akhumphrey/guitar-amplifiers/README.md

# Guitar Amplifiers

This repository contains the source files for the guitar amplifier projects I take on.

## The Amps

1. [1224](1224) - a 5F2-A style amplifier constructed from parts salvaged from a vintage [Philco model 1224](https://www.vintageradio.co.nz/model/philco/1224) tablegram.
1. [7vdw](7vdw) - a 6G2 style amplifier constructed from parts salvaged from the radio chassis portion of a vintage [Columbus model 7VDW](https://www.vintageradio.co.nz/model/columbus/7vdw) stereogram.

## References

I took a lot of learning and guidance from other circuits and the teaching of much more learned individuals while coming up with these designs. I stand upon the shoulders of giants, some of which are mentioned here in no particular order:

### General

- [https://el34world.com/charts/grounds.htm](https://el34world.com/charts/grounds.htm)
- [https://www.ampbooks.com/mobile/amplifier-calculators/cathode-capacitor/calculator/](https://www.ampbooks.com/mobile/amplifier-calculators/cathode-capacitor/calculator/)
- [https://www.youtube.com/playlist?list=PLhk_5-kIFMR6hYTqkiCGOVxa3RP3x8FsA](https://www.youtube.com/playlist?list=PLhk_5-kIFMR6hYTqkiCGOVxa3RP3x8FsA)
- [https://www.analogethos.com/blog/search/tube%20amplifier](https://www.analogethos.com/blog/search/tube%20amplifier)
- [https://northcoastsynthesis.com/news/how-to-choose-component-values/](https://northcoastsynthesis.com/news/how-to-choose-component-values/)
- [https://www.valvewizard.co.uk/localfeedback.html](https://www.valvewizard.co.uk/localfeedback.html)
- [https://el34world.com/charts/currentflow.htm](https://el34world.com/charts/currentflow.htm)

### Load Lines

- [https://robrobinette.com/Drawing_Tube_Load_Lines.htm](https://robrobinette.com/Drawing_Tube_Load_Lines.htm)
- [https://www.analogethos.com/post/load-lines](https://www.analogethos.com/post/load-lines)

### Biasing

- [https://robrobinette.com/How_to_Bias_a_Tube_Amp.htm](https://robrobinette.com/How_to_Bias_a_Tube_Amp.htm)
- [https://www.youtube.com/watch?v=L3rRk3eSTnA](https://www.youtube.com/watch?v=L3rRk3eSTnA)
- [https://www.youtube.com/watch?v=ucG3s863x1c](https://www.youtube.com/watch?v=ucG3s863x1c)
- [https://guitarscience.net/tsc/info.htm](https://guitarscience.net/tsc/info.htm)
- [https://www.youtube.com/watch?v=BatwDYFJ9ug](https://www.youtube.com/watch?v=BatwDYFJ9ug)
- [https://www.ampbooks.com/mobile/classic-circuits/bassman-tonestack/](https://www.ampbooks.com/mobile/classic-circuits/bassman-tonestack/)
- [https://robrobinette.com/How_The_TMB_Tone_Stack_Works.htm](https://robrobinette.com/How_The_TMB_Tone_Stack_Works.htm)
