akhumphrey/guitar-amplifiers/1224/layouts/eyelet/main.png

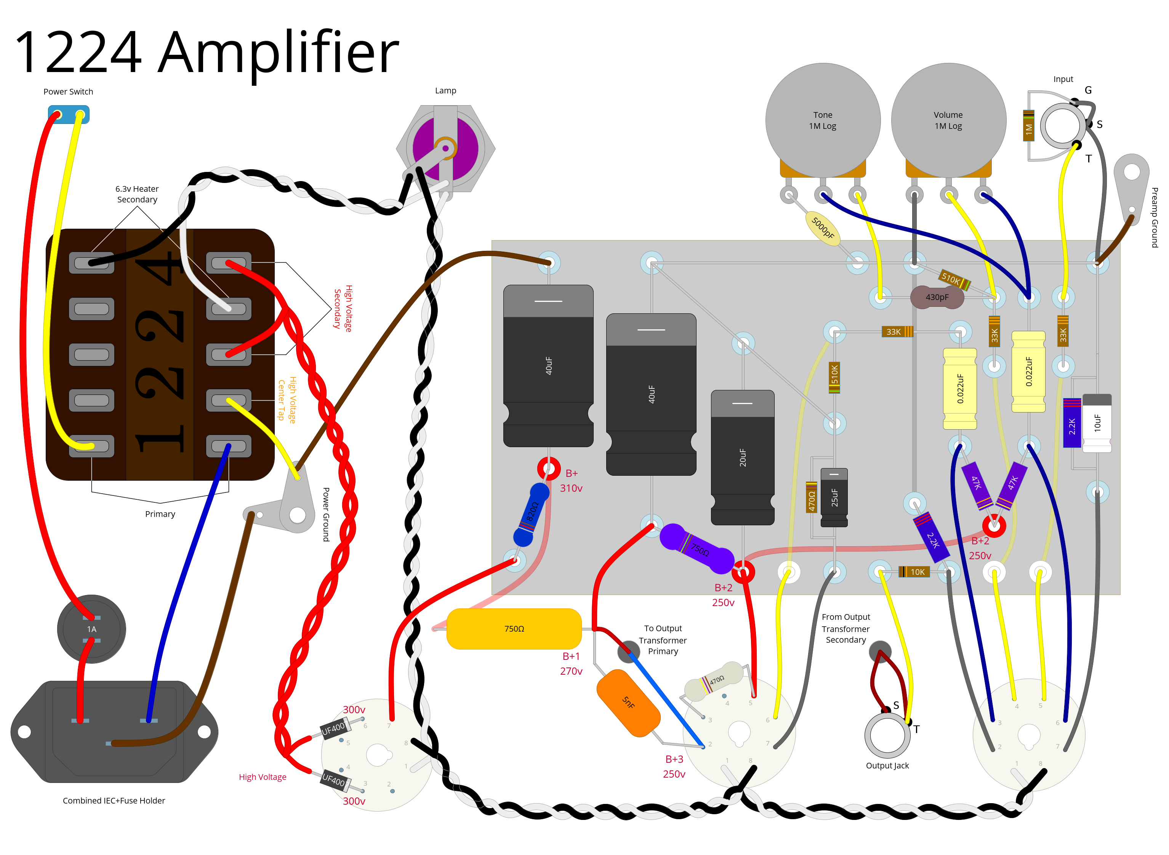
1224/layouts/eyelet/main.png
