akhumphrey/guitar-amplifiers/7vdw/layout/main.pdf

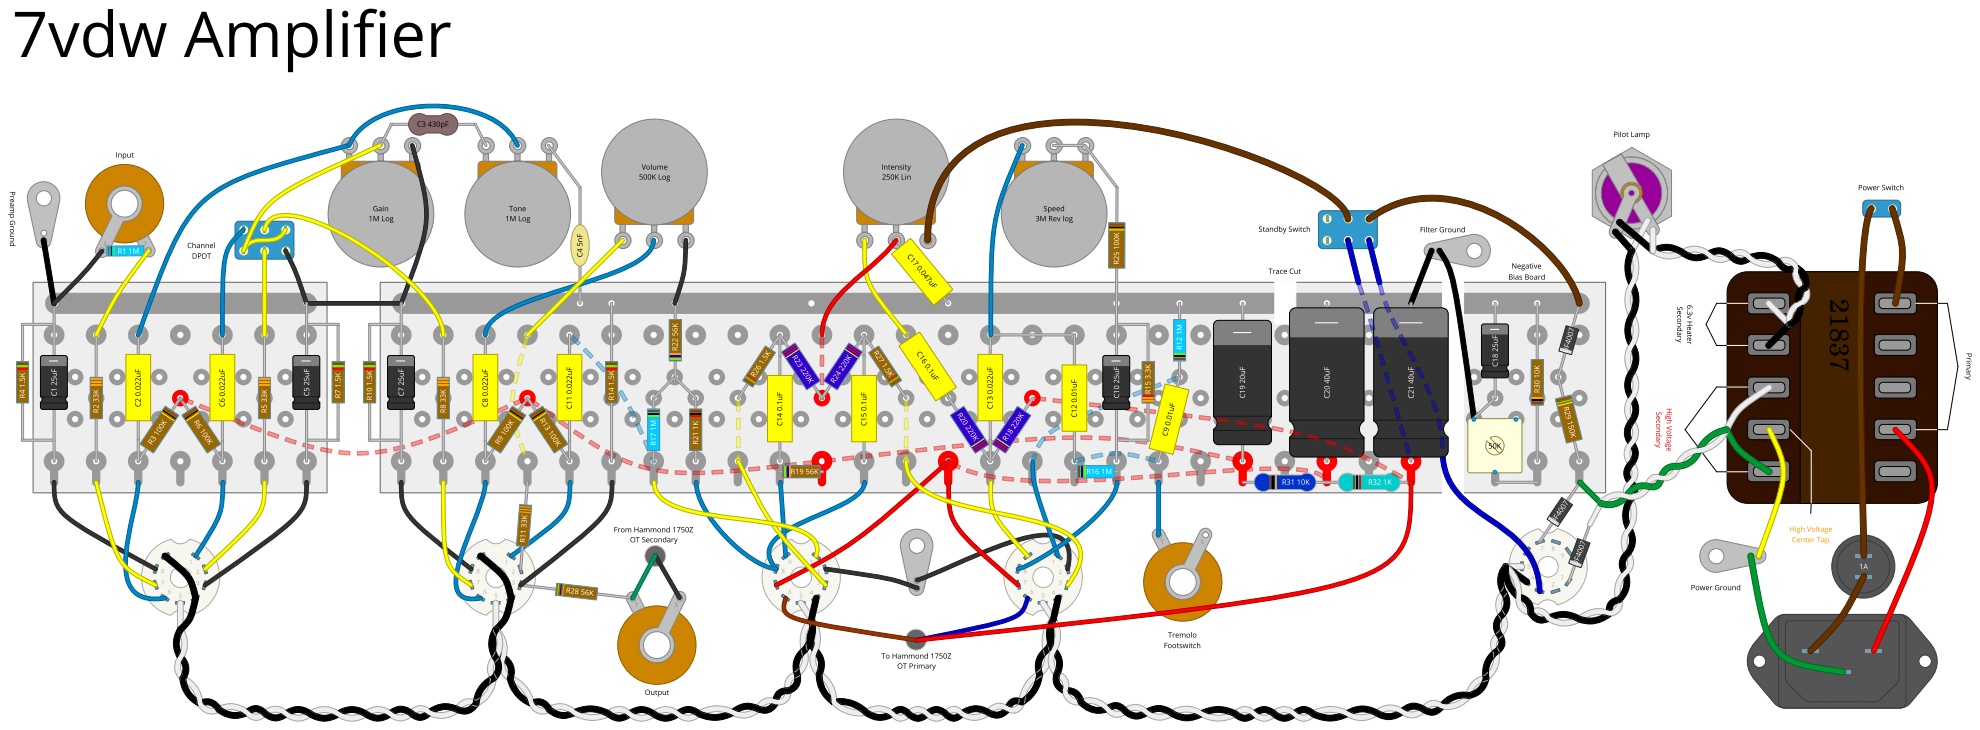
[picture p6: page 1]
