akhumphrey/guitar-amplifiers/1224/layouts/eyelet/main.pdf

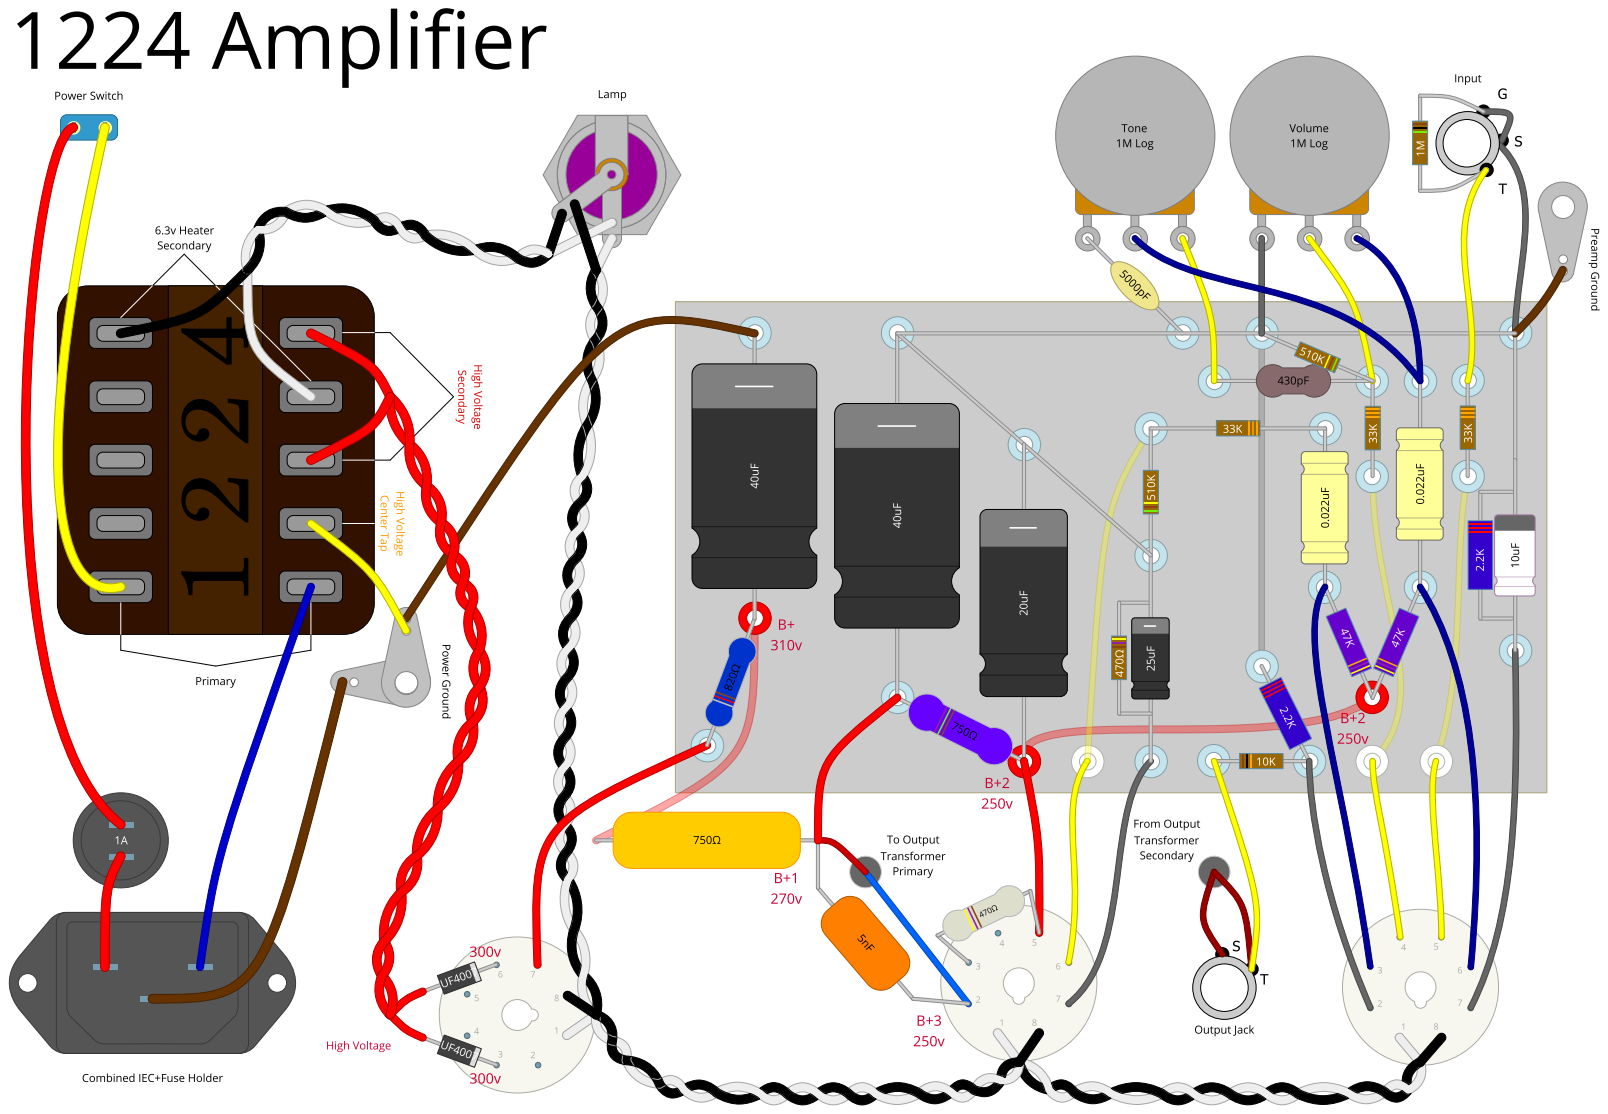
[picture p7: page 1]
