akhumphrey/guitar-amplifiers/1224/layouts/turret/main.pdf

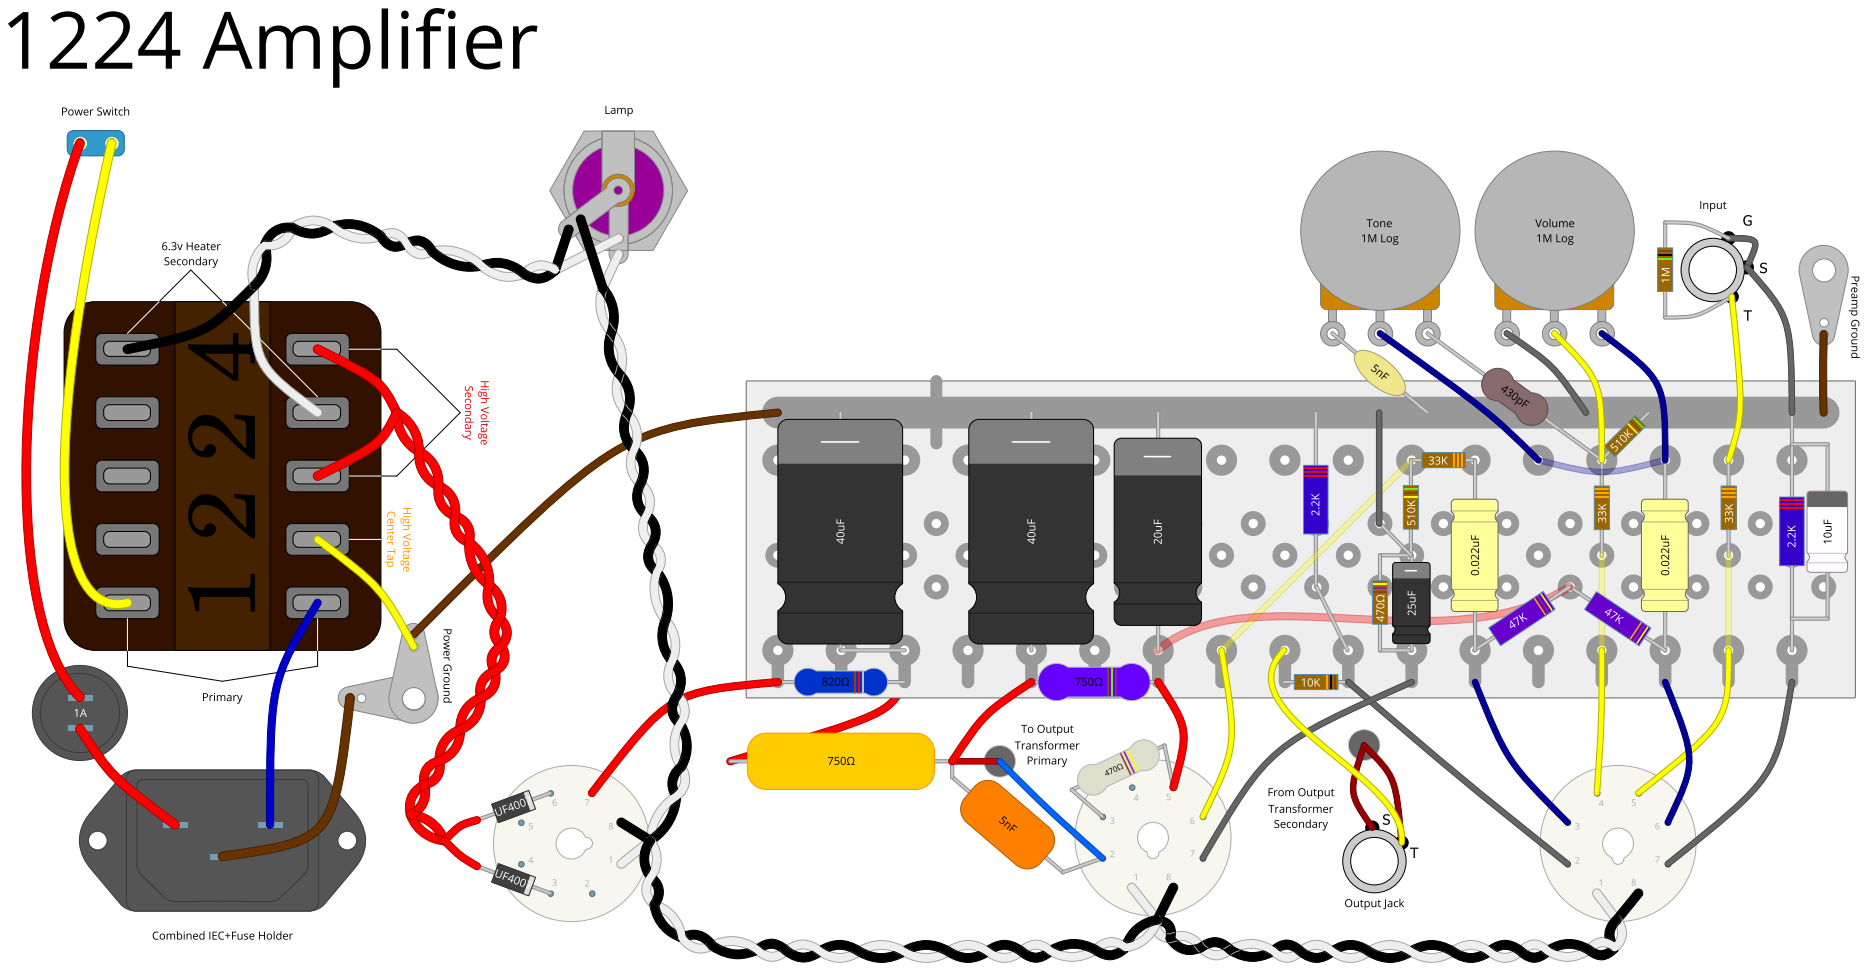
[picture p8: page 1]
