akhumphrey/guitar-amplifiers/1224/layouts/eyelet/underside.pdf

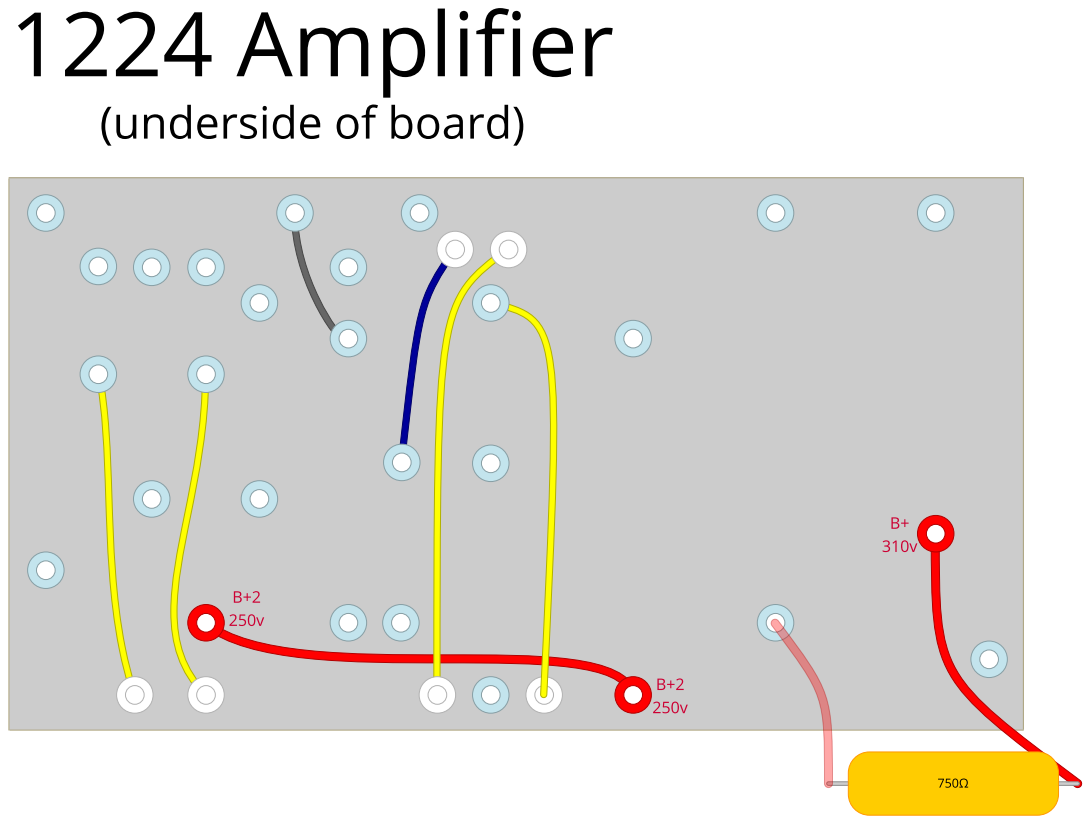
[picture p9: page 1]
