akhumphrey/guitar-amplifiers/(commit log)

2023-12-23 basic topology done
    [1224.sch]
2023-12-23 moved tone stack, changed tone stack to 5f6-a style
    [1224.sch]
2023-12-23 flipped filter caps for less wire crossing, added grid resistors
    [1224.sch]
2023-12-23 updated author
    [1224.sch]
2023-12-23 updated cap voltage ratings
    [1224.sch]
2023-12-23 added impedance resistor to output tube
    [1224.sch]
2023-12-23 added basic BOM
    [bom.csv]
2023-12-27 first draft of chassis layout (#1)
    * first draft of layout
    * added 470ohm screen resistor to 7C5
    [1224.sch]
2023-12-27 updated BOM to include 7C5 screen resistor
    [bom.csv]
2023-12-27 corrected location of screen resistor in schematic
    [1224.sch]
2023-12-28 increased power ratings of passive components tweaked labels improved 6.3v secondary winding colours changed C7 from ceramic to silver mica
    [1224.sch, bom.csv]
2023-12-28 added image/pdf renders of the schematic and layout
2024-01-02 modified grounding to split first filter cap
    [1224.sch]
2024-01-02 added description of split filter cap grounding and reference links to `README`
2024-01-04 corrected component values and ratings across schematic, layout and BOM
    [1224.sch, bom.csv]
2024-01-11 minor tweaks to wire joints and layout
2024-01-14 created underside layout, restructured filenames
    [schematic.sch]
2024-01-25 tweaked iec+power transformer locations in layout
    additional minor tweaks to wiring, labels and main power resistor
    [schematic.sch]
2024-02-16 major redesign to simplify
    [bom.csv, schematic.sch]
2024-02-19 more accurate power transformer, extensive tidying
2024-03-01 more refinements to simplified design
    [bom.csv, schematic.sch]
2024-03-16 another major overhaul
    [main.sch]
2024-03-24 updated schematic image render
2024-04-27 removed negative feedback pot
    [main.sch]
2024-05-06 unified repository
    [bom.csv, main.sch]
2024-05-06 imported wip 7vdw files
    [bom.csv, main.sch]
2024-05-11 updated tube compliment
    [main.sch]
2024-05-12 started building out bom
    [bom.csv, main.sch]
2024-05-14 updated schematic render
2024-05-14 more bom content
    [bom.csv]
2024-05-14 min diode ratings
    [bom.csv]
2024-05-15 added missing diode, tweaked values+ratings
    [bom.csv, main.sch]
2024-05-24 added capacitor polarity, corrected values
    [bom.csv, main.sch]
2024-05-26 layout progress
    [main.sch]
2024-05-27 added more components to the layout
    [main.sch]
2024-05-28 replaced input, added output and footswitch jacks
    [main.sch]
2024-05-28 more layout progress, corrected some component values
    [bom.csv, main.sch]
2024-05-29 heaps more layout progress
    [main.sch]
2024-05-30 mostly finished board wiring
    [main.sch]
2024-06-06 added standby switch, removed output balance trimpot
    [main.sch]
2024-06-10 fixed up some component labels, added name + value to schematic and layout
    [bom.csv, main.sch]
2024-06-11 tweaked bom, corrected some colours and ratings
    [bom.csv]
2024-06-15 flipped layout horizontally, increased underside wiring visibility, updated README
2024-07-18 added another preamp tube w/switchable gain stage
    [bom.csv, main.sch]
2024-07-29 changed standby to DPDT, tweaked wire colours
    [main.sch]
2024-08-02 increased negative feedback resistor value, added dropping resistors to heater taps
    [main.sch]
2024-08-11 increased heater resistors
2024-08-12 removed heater resistors
    [main.sch]
2024-08-18 made pot values visible on schematic
    [main.sch]
